dancarCwC/brazo-de-6-grados/sitio/img/brazo.jpg

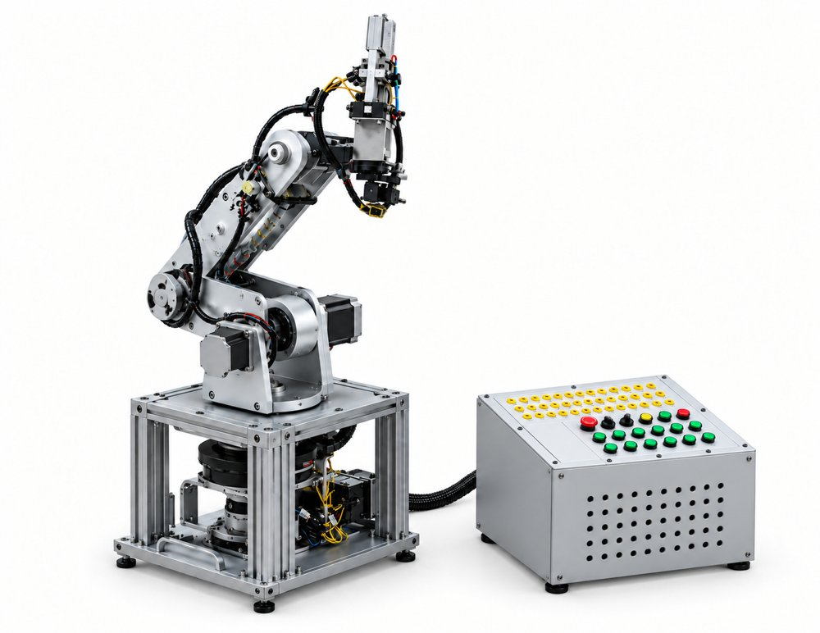
sitio/img/brazo.jpg
