dancarCwC/brazo-de-6-grados/sitio/img/tarjeta.jpg

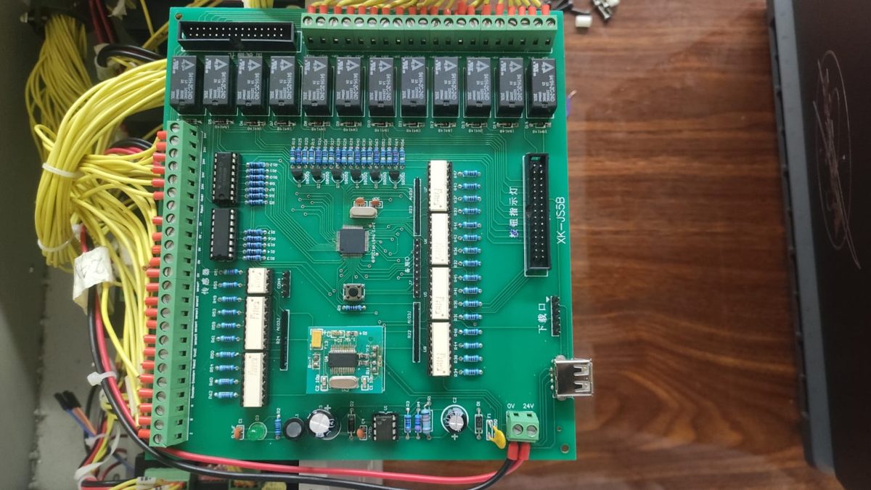
sitio/img/tarjeta.jpg
