dancarCwC/brazo-de-6-grados/(list of files, cad)

Other CAD files:
DIAGRAMAS P&ID/DIAGRAMA P&ID B6G.dwg
documentacion/PULSADORES.dwg
