dancarCwC/brazo-de-6-grados/DIAGRAMAS P&ID/DIAGRAMA P&ID B6G-Modelo.pdf

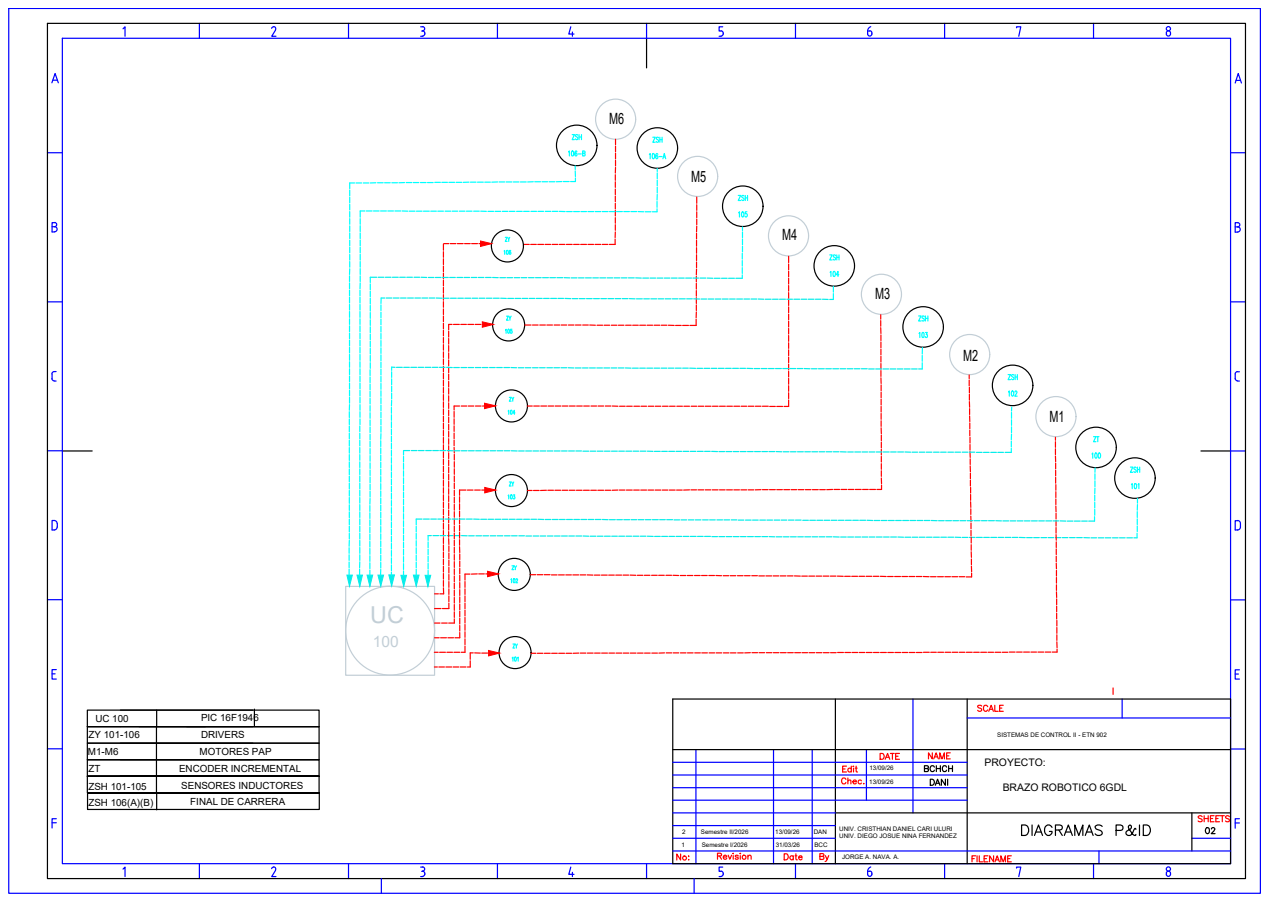
[picture p24: page 1]
SISTEMAS DE CONTROL II - ETN 902 13/09/26 JORGE A. NAVA. A.; PROYECTO: BRAZO ROBOTICO 6GDL 1; Semestre I/2026; 13/09/26 BCC; Semestre II/2026; DAN; PIC 16F1946 ZY 101-106; DRIVERS M1-M6 ZTZSH 101-105 ZSH 106(A)(B); MOTORES PAP ENCODER INCREMENTAL SENSORES INDUCTORES FINAL DE CARRERA; UNIV. CRISTHIAN DANIEL CARI ULURI

CRISTHIAN DANIEL CARI ULURI UNIV. DIEGO JOSUE NINA FERNANDEZ
