dancarCwC/brazo-de-6-grados/PINAJE PIC16F1946/PIC16F1946/PINAJE PIC16F1946.pdf

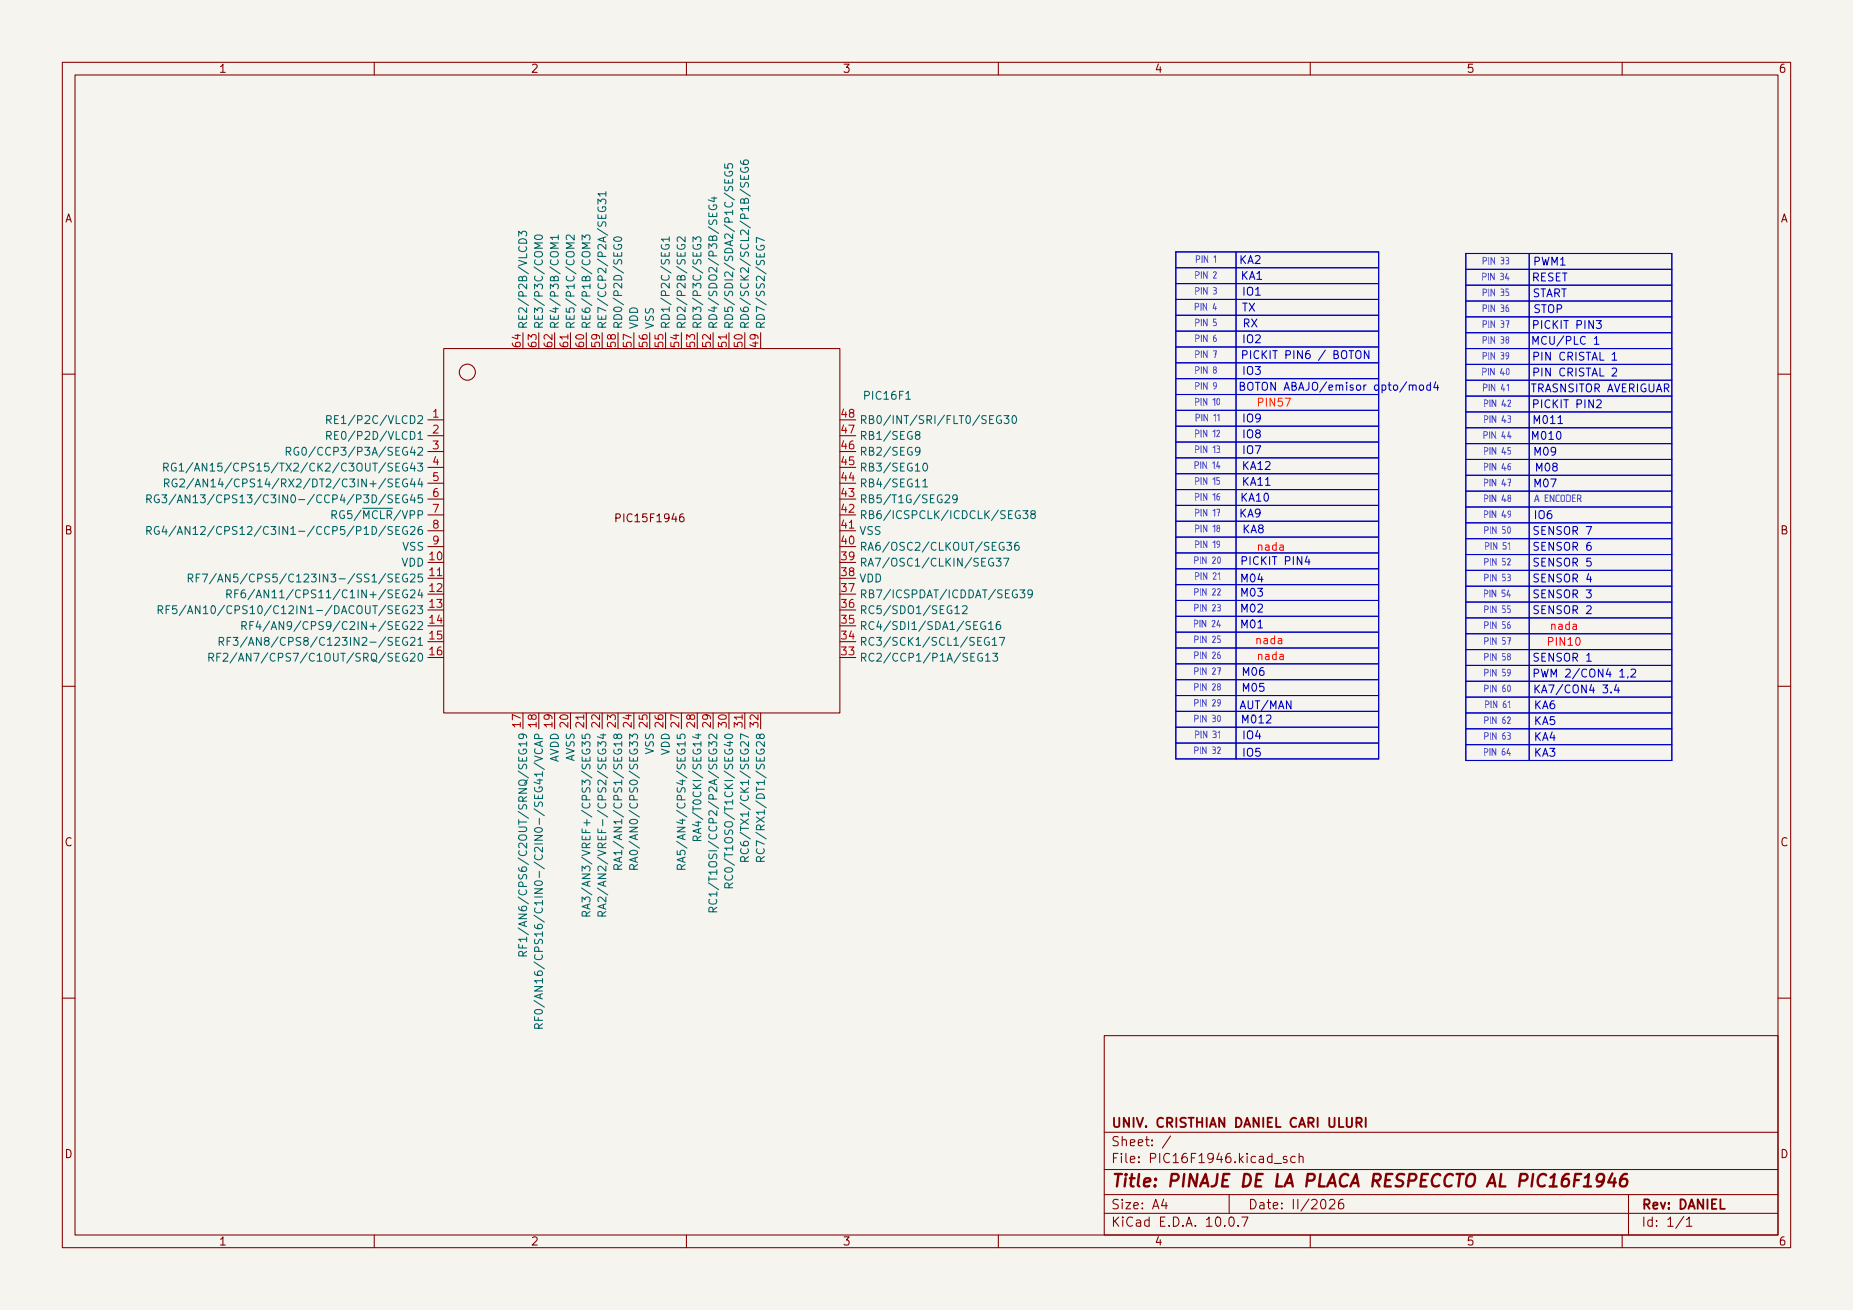
[picture p25: page 1]
