dancarCwC/brazo-de-6-grados/(commit log)

2026-10-13 Agregada documentacion de la planta
2026-11-08 guias
    guias de laboratorio del II/2026
